pep248/SolarFollower/README.md

# Solar Follower

This repository contains a project with the design of a solar follower and its remote control, along with the Arduino codes to control them.
The repository also contains a LabVIEW program to monitor the solar panel readings and to switch from manual to automatic control.

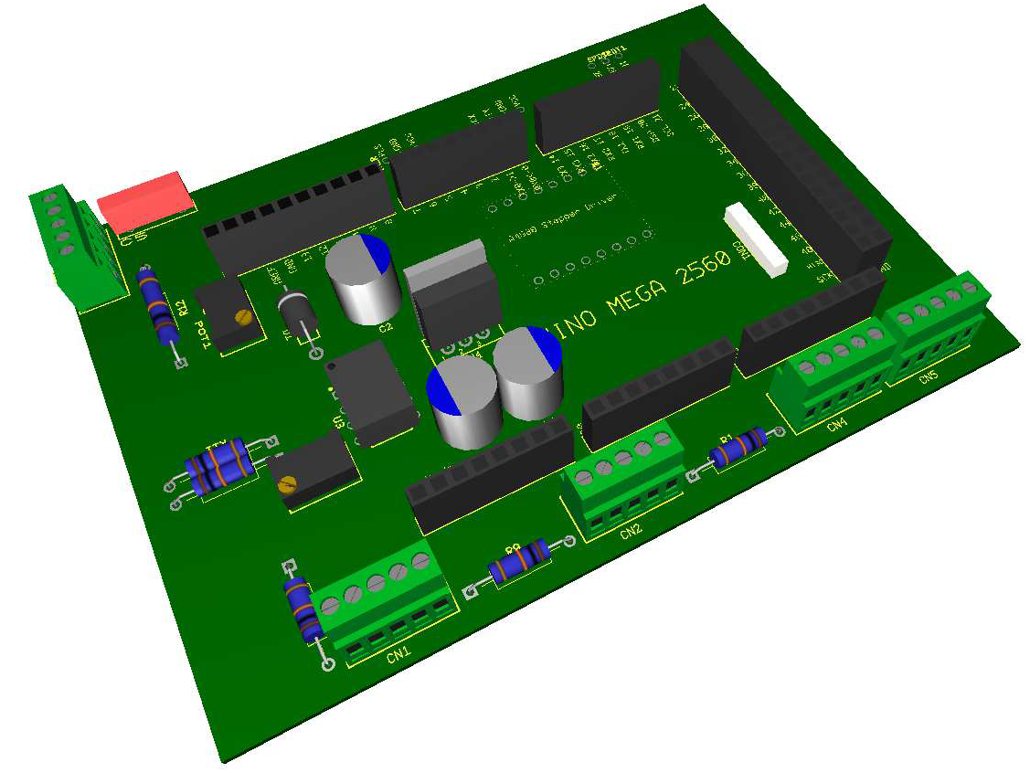
[picture p1: Design/render.jpg]
Render


## Folders
* Inside the [Arduino](Arduino) folder, we can find the code for the solar follower and the code for the remote control.
* Inside the [LabVIEW](LabVIEW) folder, we can find the LabVIEW project with the program to monitor and control the solar panel.
* Inside the [Design](Design) folder, we can find the Multisim assembly of components and the Ultiboard design of the PCB.

## Author
* Josep Rueda Collell: rueda_999@hotmail.com
* Nèlia de Pallejà i Palomeras: u1915530@gmail.com
