pep248/SolarFollower/Design/PCB.pdf

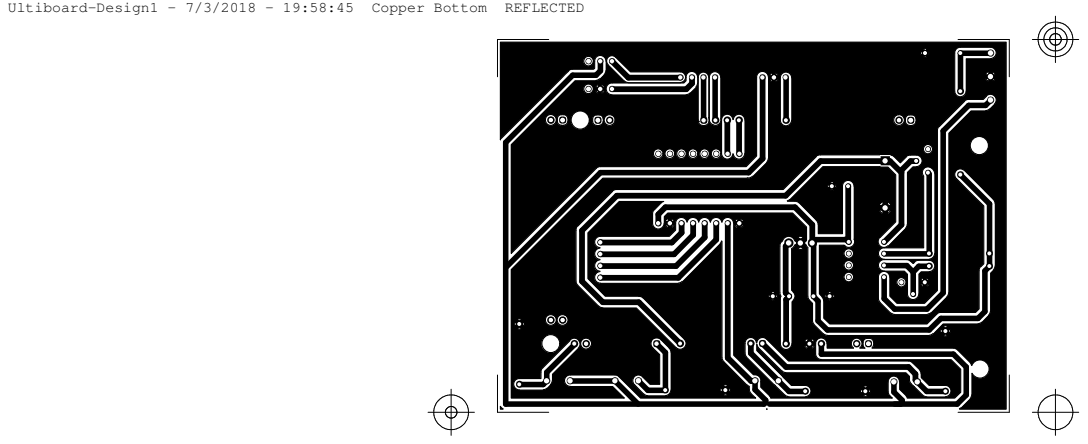
[picture p9: page 1]
Ultiboard-Design1 - 7/3/2018 - 19:58:45; Copper Bottom; REFLECTED
