pep248/SolarFollower/(list of files, drawings)

Other design files:
Design/DISSENY.ms14
